rabinah1/PIC-FPGA/(list of files, cad)

Other CAD files:
test1.stp
