rabinah1/PIC-FPGA/hw/src/serial_to_parallel_instruction.vhd

library ieee;
use ieee.std_logic_1164.all;
use ieee.numeric_std.all;
use ieee.std_logic_unsigned.all;
use work.states_package.all;
use work.constants_package.all;

entity serial_to_parallel_instruction is
    port (
        clk                : in    std_logic;
        reset              : in    std_logic;
        enable             : in    std_logic;
        binary_string      : in    std_logic_vector(13 downto 0);
        sel_alu_input_mux  : out   std_logic;
        sel_alu_demux      : out   std_logic;
        trig_state_machine : out   std_logic;
        transfer_to_sw     : out   std_logic;
        instruction_type   : out   std_logic_vector(2 downto 0);
        literal_out        : out   std_logic_vector(7 downto 0);
        address_out        : out   std_logic_vector(6 downto 0);
        bit_idx_out        : out   std_logic_vector(2 downto 0);
        opcode_out         : out   std_logic_vector(5 downto 0)
    );
end entity serial_to_parallel_instruction;

architecture rtl of serial_to_parallel_instruction is

begin

    -- Incoming data type: <6 bit opcode> + <7 bit address or operand>
    serial_to_parallel_instruction : process (all) is

        variable opcode_var : std_logic_vector(5 downto 0);

    begin

        if (reset = '1') then
            literal_out        <= (others => '0');
            address_out        <= (others => '0');
            opcode_out         <= (others => '0');
            bit_idx_out        <= (others => '0');
            sel_alu_input_mux  <= '0';
            sel_alu_demux      <= '0';
            trig_state_machine <= '0';
            transfer_to_sw     <= '0';
            instruction_type   <= (others => '0');
            opcode_var         := (others => '0');
        elsif (rising_edge(clk)) then
            if (enable = '1') then
                if (binary_string(13 downto 12) = "01") then -- bit-oriented instruction
                    opcode_out         <= binary_string(13 downto 10) & "00";
                    bit_idx_out        <= binary_string(9 downto 7);
                    address_out        <= binary_string(6 downto 0);
                    literal_out        <= (others => '0');
                    sel_alu_input_mux  <= '1';
                    sel_alu_demux      <= '1';
                    transfer_to_sw     <= '0';
                    instruction_type   <= "010";
                    trig_state_machine <= '1';
                else
                    opcode_var := binary_string(13 downto 8);
                    if (opcode_var = DUMP_EEPROM) then
                        opcode_out         <= binary_string(13 downto 8);
                        bit_idx_out        <= (others => '0');
                        address_out        <= (others => '0');
                        literal_out        <= (others => '0');
                        sel_alu_input_mux  <= '0';
                        sel_alu_demux      <= '0';
                        transfer_to_sw     <= '0';
                        instruction_type   <= "110";
                        trig_state_machine <= '1';
                    elsif (opcode_var = DUMP_RAM) then
                        opcode_out         <= binary_string(13 downto 8);
                        bit_idx_out        <= (others => '0');
                        address_out        <= (others => '0');
                        literal_out        <= (others => '0');
                        sel_alu_input_mux  <= '0';
                        sel_alu_demux      <= '0';
                        transfer_to_sw     <= '0';
                        instruction_type   <= "101";
                        trig_state_machine <= '1';
                    elsif (opcode_var = READ_ADDRESS) then
                        opcode_out         <= binary_string(13 downto 8);
                        bit_idx_out        <= (others => '0');
                        address_out        <= binary_string(6 downto 0);
                        literal_out        <= (others => '0');
                        sel_alu_input_mux  <= '1';
                        sel_alu_demux      <= '0';
                        transfer_to_sw     <= '1';
                        instruction_type   <= "100";
                        trig_state_machine <= '1';
                    elsif (opcode_var = READ_WREG or opcode_var = READ_STATUS) then
                        opcode_out         <= binary_string(13 downto 8);
                        bit_idx_out        <= (others => '0');
                        address_out        <= (others => '0');
                        literal_out        <= (others => '0');
                        sel_alu_input_mux  <= '0';
                        sel_alu_demux      <= '0';
                        transfer_to_sw     <= '1';
                        instruction_type   <= "011";
                        trig_state_machine <= '1';
                    elsif (opcode_var = ADDWF or opcode_var = ANDWF or opcode_var = COMF or
                           opcode_var = DECF or opcode_var = DECFSZ or opcode_var = INCF or
                           opcode_var = INCFSZ or opcode_var = IORWF or opcode_var = MOVF or
                           opcode_var = SUBWF or opcode_var = XORWF or opcode_var = RLF or
                           opcode_var = RRF or opcode_var = CLR or opcode_var = SWAPF) then
                        opcode_out        <= binary_string(13 downto 8);
                        bit_idx_out       <= (others => '0');
                        address_out       <= binary_string(6 downto 0);
                        literal_out       <= (others => '0');
                        sel_alu_input_mux <= '1'; -- input to ALU will be from memory
                        sel_alu_demux     <= binary_string(7);
                        transfer_to_sw    <= '0';
                        if (binary_string(7) = '0') then
                            instruction_type <= "001";
                        else
                            instruction_type <= "010";
                        end if;
                        trig_state_machine <= '1';
                    else
                        opcode_out         <= binary_string(13 downto 8);
                        bit_idx_out        <= (others => '0');
                        address_out        <= (others => '0');
                        literal_out        <= binary_string(7 downto 0);
                        sel_alu_input_mux  <= '0'; -- input to ALU will be from literal
                        sel_alu_demux      <= '0';
                        transfer_to_sw     <= '0';
                        instruction_type   <= "000";
                        trig_state_machine <= '1';
                    end if;
                end if;
            else
                trig_state_machine <= '0';
            end if;
        end if;

    end process serial_to_parallel_instruction;

end architecture rtl;
