rabinah1/PIC-FPGA/hw/src/alu_output_demux.vhd

library ieee;
use ieee.std_logic_1164.all;

entity alu_output_demux is
    port (
        clk            : in    std_logic;
        reset          : in    std_logic;
        sel            : in    std_logic;
        transfer_to_sw : in    std_logic;
        input_data     : in    std_logic_vector(7 downto 0);
        data_to_ram    : out   std_logic_vector(7 downto 0);
        data_to_sw     : out   std_logic_vector(7 downto 0);
        data_to_wreg   : out   std_logic_vector(7 downto 0)
    );
end entity alu_output_demux;

architecture rtl of alu_output_demux is

begin

    alu_output_demux : process (all) is
    begin

        if (reset = '1') then
            data_to_wreg <= (others => '0');
            data_to_ram  <= (others => '0');
            data_to_sw   <= (others => '0');
        else
            if (transfer_to_sw = '1') then
                data_to_wreg <= (others => '0');
                data_to_ram  <= (others => '0');
                data_to_sw   <= input_data;
            elsif (sel = '0') then
                data_to_wreg <= input_data;
                data_to_ram  <= (others => '0');
                data_to_sw   <= (others => '0');
            else
                data_to_wreg <= (others => '0');
                data_to_ram  <= input_data;
                data_to_sw   <= (others => '0');
            end if;
        end if;

    end process alu_output_demux;

end architecture rtl;
