rabinah1/PIC-FPGA/(commit log)

2019-11-03 Add file for experimentation with raspberry pi gpio and threading.
2020-02-16 Communication between raspberry pi and FPGA working
2020-02-16 Increase clock frequency to 200 Hz
2020-05-02 Add signaltap testing file
    [test1.stp]
2020-07-30 Add initial state machine implementation
    [test1.stp]
2020-08-12 Add initial RAM implementation
    [test1.stp]
2021-02-14 Add few FPGA fixes
    [serial_to_parallel_instruction.vhd]
2021-07-08 Improve error checking in SW
    [gpio_program.c]
2021-08-22 Add Arduino Nano as a new slave
2021-09-05 Connect temperature sensor to arduino
2021-11-24 Create initial VHDL testbench
    [test1.stp]
2021-12-04 Add unit test framework
    Changes:
    * Implement first unit tests with CppUtest framework
    * Add a makefile
2021-12-12 Create Quartus automation scripts for Windows Powershell
2021-12-26 Switch to raspberry pi 4 model B
2022-07-14 Add SW cross compilation, refactor code and add more UTs
    [gcovr.cfg, sim2833x.cfg]
2023-01-06 Add UT improvements
    [gcovr.cfg, sim2833x.cfg]
2023-01-15 Refactor code
    * Refactor SW code
    * Fix UTs so that all SW code can be compiled for UTs
    * Add support to dynamically change the clock frequency
    [app.c, common_data.c, common_data.h, defines.h, gpio_setup.c, hw_if.c, hw_if.h]
2023-03-12 Add new switches for fpga_tool.ps1
2023-06-04 Add arduino-support to makefile
2023-06-18 Exclude Arduino build files from style check
2024-01-01 Switch development environment to Linux
2024-01-14 Add initial device driver for a simple adder
2025-01-05 Add general improvements
    * Add automatic installation of cpputest when needed
    * Improve error handling
    * Refactor code
    [app.c, common_data.c, common_data.h, defines.h, gpio_setup.c, hw_if.c, hw_if.h]
